anadskman/3D-Scanner/README.md

# Portable 3D Scanner


A custom-designed portable 3D scanner built from scratch in Fusion 360 and KiCad. The scanner uses a motorised arch and rotating turntable to capture objects from different angles and create 3D models.

The design uses an ESP32, two NEMA 17 stepper motors, DRV8825 drivers and a 1080p USB camera.

## Overview

The scanner uses two motorised axes:

- Rotating turntable to move the object
- Motorised arch to move the camera around the object

The camera captures images from different angles while the ESP32 controls the movement of both motors.

The USB camera connects directly to a computer, where the images can be processed into a 3D model.

The main goal is to create a compact scanner that can be transported easily and used to scan smaller objects.

## Features

- Fully custom CAD design
- Custom designed PCB
- Motorised rotating turntable
- Motorised camera arch
- Internal gear mechanism
- 1080p USB camera
- WS2812 LED lighting
- Automatic homing using limit switches
- ESP32 motor control
- 3D printed components
- Modular and detachable components
- Designed to be portable

## Design Process

### Initial Concept

The original idea was to make a portable 3D scanner using a rotating turntable and a camera mounted on a curved arch.

Instead of moving multiple cameras around the object, the design uses one camera that can move to different positions while the turntable rotates.

The main parts were designed in Fusion 360, with the electronics designed separately in KiCad.

### Arch Mechanism

The arch holds the camera and allows it to move around the object.

The design uses an internal gear system to move the camera along the arch using a NEMA 17 stepper motor.

The arch includes:

- Internal gear teeth
- NEMA 17 motor mounting
- Camera mounting bracket
- Detachable mounting points
- Space for cable routing

The gear teeth were generated using Helix Gear+ in Fusion 360 rather than modelling each tooth individually.

### Turntable

The turntable rotates the object during scanning.

It uses a separate NEMA 17 stepper motor controlled by a DRV8825 driver.

The turntable is designed to hold smaller objects while keeping them centred during rotation.

### Camera Mount

The camera mount was designed specifically around the InnoMaker USB camera.

It attaches to the moving arch and holds the camera in position while allowing it to point towards the centre of the turntable.

### PCB Housing

A custom housing was designed for the PCB.

The housing includes cutouts for the barrel jack, screw terminals and connectors. It also has mounting holes for attaching the top and bottom sections together.

The ESP32 is removable rather than permanently enclosed inside the case.

## Electronics

### Components

- ESP32 Development Board
- 2× DRV8825 Stepper Drivers
- 2× NEMA 17 Stepper Motors
- InnoMaker 1080p USB Camera
- WS2812 RGB LED Ring
- 3× Limit Switches
- 12V Power Supply
- 5V Buck Converter
- Custom PCB

### PCB

The PCB was designed in KiCad and exported as a STEP model so it could be imported into Fusion 360.

This allowed the electronics to be placed into the mechanical assembly to check clearances and mounting positions.

## CAD Improvements

Several improvements were made throughout the design:

- Custom internal gear mechanism
- Modular motor mounts
- Detachable arch assembly
- Custom camera mount
- PCB housing with removable ESP32
- Standardised screw sizes
- STEP exports for individual components
- Full assembly with joints for movement testing
- PCB uploaded into Fusion 360 for clearance checking

## Bill of Materials

| **Name** | **Purpose** | **Quantity Purchased** | **Quantity Used** | **Link** | **Total Cost (EUR)** | **Distributor** |
| --- | --- | --- | --- | --- | --- | --- |
| InnoMaker 1080p USB Camera | Captures images of the object | 1 | 1 | [Amazon](https://www.amazon.ie/gp/product/B0CNCSFQC1/ref=ox_sc_act_title_5?smid=A3LR51RN935ZZX&psc=1) | €20.92  | Amazon |
| NEMA 17 Stepper Motors | Drives the turntable and arch | 3 | 2 | [Amazon](https://www.amazon.ie/gp/product/B0FSPZT9P4/ref=ox_sc_act_title_4?smid=A3JL2PT0MX26A6&psc=1) | €27.00 | Amazon |
| WS2812 LED Rings | Provides lighting around the object | 5 | 1 | [Amazon](https://www.amazon.ie/gp/product/B0CMW5LWM2/ref=ox_sc_act_title_3?smid=A35XDNP896ERNI&psc=1) | €8.19 | Amazon |
| Limit Switches | Used for homing and movement limits | 3 | 3 | [Amazon](https://www.amazon.ie/Official-Switch-3-Piece-Compatible-Printers/dp/B09R3TWDSV/ref=sr_1_20?sr=8-20) | €4.99  | Amazon |
| ESP32 Development Board | Main controller for the scanner | 1 | 1 | [Amazon](https://www.amazon.ie/DollaTek-Development-Bluetooth-compatible-Ultra-Low-Consumption/dp/B0CXT3978J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) | 7.99  | Amazon |
| DRV8825 Stepper Drivers | Controls the NEMA 17 motors | 2 | 2 | Owned | Owned | Owned |
| Custom PCB | Connects the electronics together | 1 | 1 | [JlCPCB](https://cart.jlcpcb.com/quote/gerberviewThree/?qs=2035bd6f6bf045a4be76bd0e8a033c01_1_0_1_0_0.html) | €22.63 | JlCPCB |
| 12V DC Power Supply | Main power for the scanner | 1 | 1 | Owned | Owned | Owned |
| 5V Buck Converter | Converts 12V to 5V for the ESP32 and LEDs | 1 | 1 | [Amazon](https://www.amazon.ie/Converter-Adjustable-Voltage-Efficient-Regulator/dp/B0FLYNNNWL/ref=sr_1_1?sr=8-1) | €8.99 | Amazon |
| 74AHCT125 | Logic level shifting for the LED data signal | 1 | 1 | [Amazon](https://www.amazon.ie/Be-Your-Mind-SN74AHCT125N-Three-State/dp/B0DXK7PWTN/ref=sr_1_1?sr=8-1) | €9.49 | Amazon |
| 330Ω Resistor | LED data line protection | 1 | 1 | Owned | Owned | Owned |
| 1000µF Capacitor | Smooths the LED power supply | 1 | 1 | Owned | Owned | Owned |
| 100µF Capacitors | Filters power near the stepper drivers | 2 | 2 | Owned | Owned | Owned |
| 100nF Capacitors | Decoupling for the electronics | 2+ | 2+ | Owned | Owned | Owned |
| Barrel Jack | Main power input | 1 | 1 | Owned | Owned | Owned |
| Screw Terminals / Connectors | Connects motors and power wiring | As required | As required | Owned | Owned | Owned |
| Fuse | Protects the main power input | 1 | 1 | [Amazon](https://www.amazon.ie/SeKi-Micro-Fuse-Glass-Fuses/dp/B09JZHQYR6/ref=sr_1_2?sr=8-2) | €6.88 | Amazon |
| Fuse Holder | Holds the fuse | 1 | 1 | [Amazon](https://www.amazon.ie/ECSiNG-Holder-Transparent-Terminals-5x20mm/dp/B0C4983C7C/ref=sr_1_2?sr=8-2) | €7.49 | Amazon |
| SB540 Schottky diode | reverse polarary protection | 1 | 1 | [Amazon](https://www.amazon.ie/20-Pieces-SR540-Schottky-Rectifier/dp/B079KDRFY7/ref=sr_1_2?sr=8-2) | €6.26  | Amazon |
**Total** **€130.83**

Prices are for the full packs purchased, not the cost of only the parts used. The third stepper motor and spare LED rings are included in the purchase quantities.

## Project Images

### CAD



### PCB



### Schematic



---

**Designed and built by Jason Clark**
