anadskman/3D-Scanner/CAD/Arch Main.stl

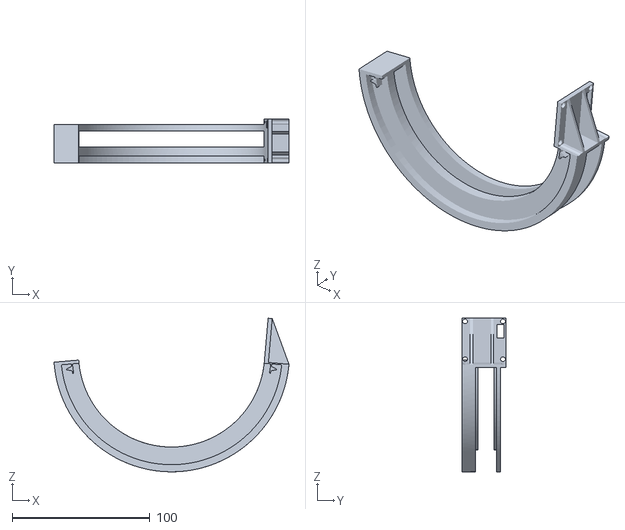
[picture p1: CAD file, 2026-11-04]
CAD/Arch Main.stl
170.5 x 32.0 x 111.5
