anadskman/3D-Scanner/CAD/Components/DRV8825_pin.stp

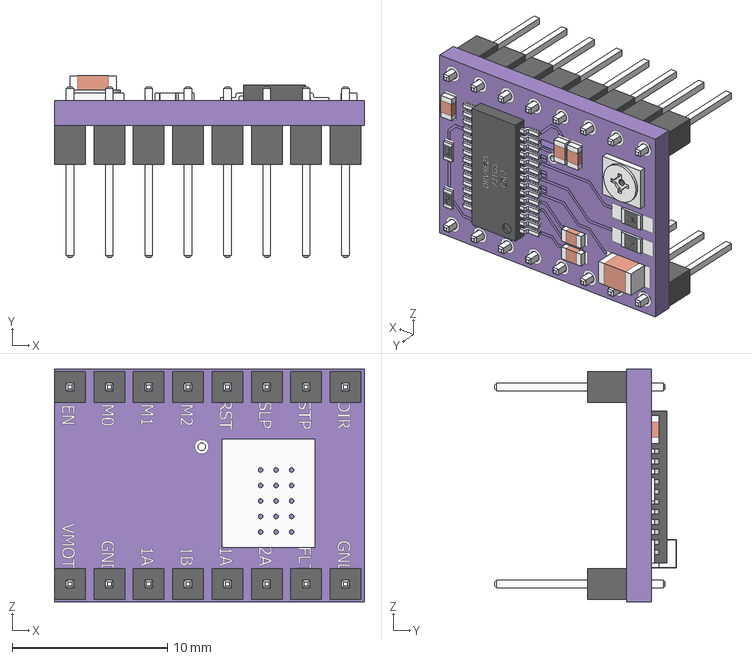
[picture p2: CAD file, 2026-10-27]
CAD/Components/DRV8825_pin.stp
20.0 x 11.7 x 15.0 mm
