anadskman/3D-Scanner/CAD/PCB Case Sides.stl

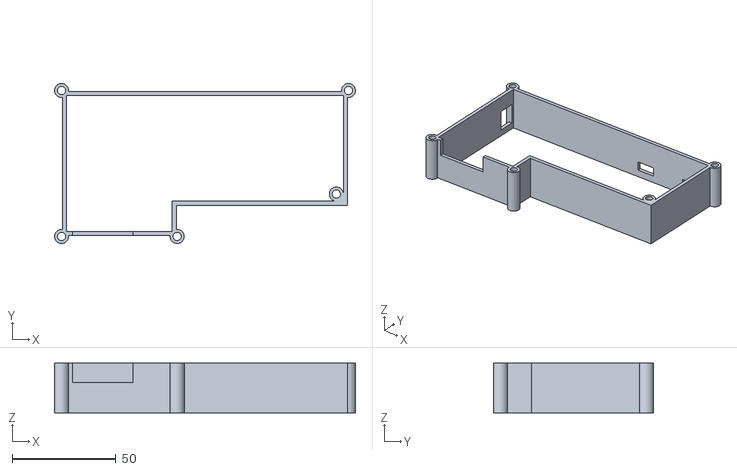
[picture p3: CAD file, 2026-11-04]
CAD/PCB Case Sides.stl
145.1 x 77.2 x 24.0
