anadskman/3D-Scanner/CAD/Components/3DScanner-PCB with models.step

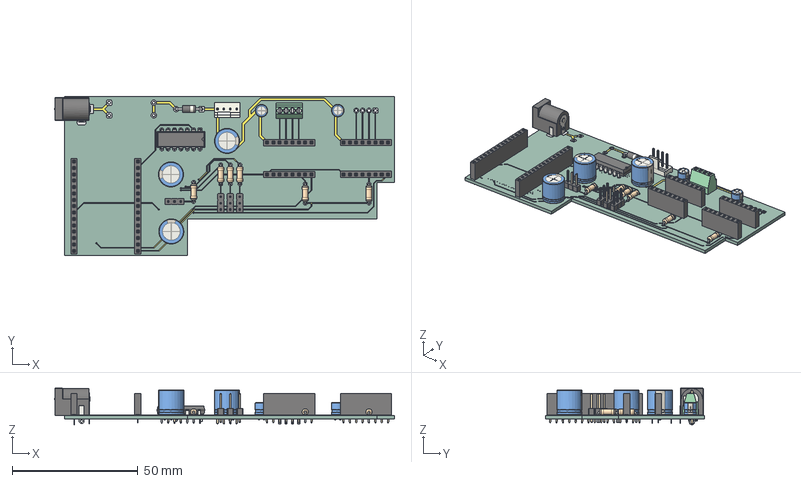
[picture p4: CAD file, 2026-10-27]
CAD/Components/3DScanner-PCB with models.step
135.4 x 63.5 x 14.6 mm
R_Axial_DIN0207_L6.3mm_D2.5mm_P7.62mm_Horizontal x 6
PinSocket_1x08_P2.54mm_Vertical x 4
PinSocket_1x15_P2.54mm_Vertical x 2
PinHeader_1x03_P2.54mm_Vertical x 4
FanPinHeader_1x04_P2.54mm_Vertical
TerminalBlock_Phoenix_MPT-0,5-4-2.54_1x04_P2.54mm_Horizontal
CP_Radial_D10.0mm_P5.00mm x 3
D_DO-41_SOD81_P10.16mm_Horizontal
CP_Radial_D5.0mm_P2.00mm x 2
DIP-14_W7.62mm
BarrelJack_Horizontal
3DScanner_copper
3DScanner_pad
3DScanner_via
3DScanner_PCB
