anadskman/3D-Scanner/CAD/Components/Innomaker-U20CAM-1080P-1 v1.step

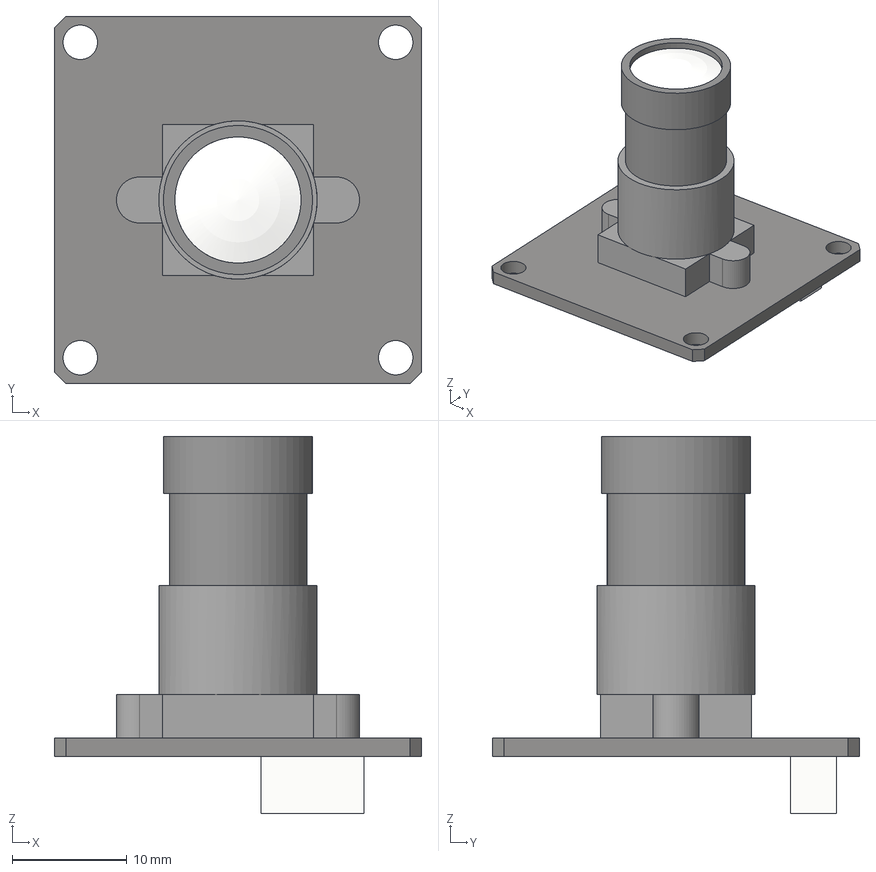
[picture p5: CAD file, 2026-10-21]
CAD/Components/Innomaker-U20CAM-1080P-1 v1.step
32.0 x 32.0 x 32.9 mm
PCB
Camera-Bot
Camera-Top
Connector
Lens
