anadskman/3D-Scanner/CAD/Guide Rails.stl

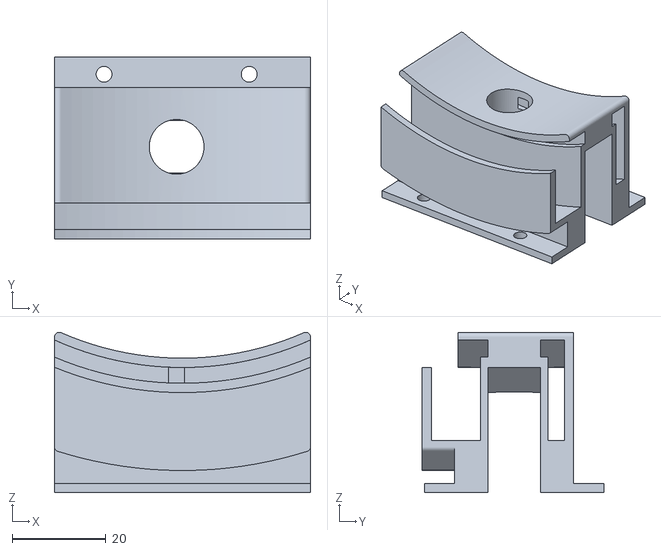
[picture p6: CAD file, 2026-11-04]
CAD/Guide Rails.stl
54.7 x 38.9 x 34.3
