anadskman/3D-Scanner/CAD/Arch 12 teeth gear.stl

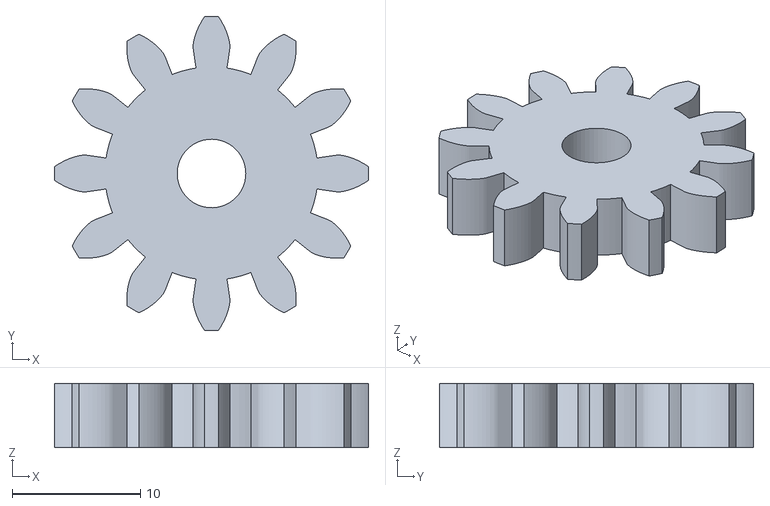
[picture p7: CAD file, 2026-11-04]
CAD/Arch 12 teeth gear.stl
24.5 x 24.5 x 5.00
