anadskman/3D-Scanner/CAD/Components/Creality Limit Switch.step

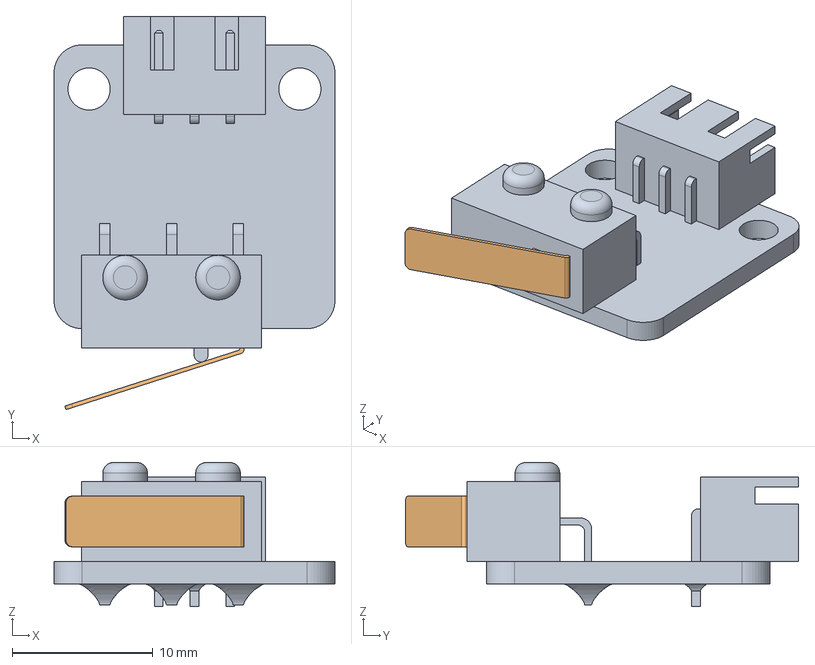
[picture p8: CAD file, 2026-10-21]
CAD/Components/Creality Limit Switch.step
20.0 x 28.0 x 10.3 mm
