anadskman/3D-Scanner/CAD/Arch Motor Mount.stl

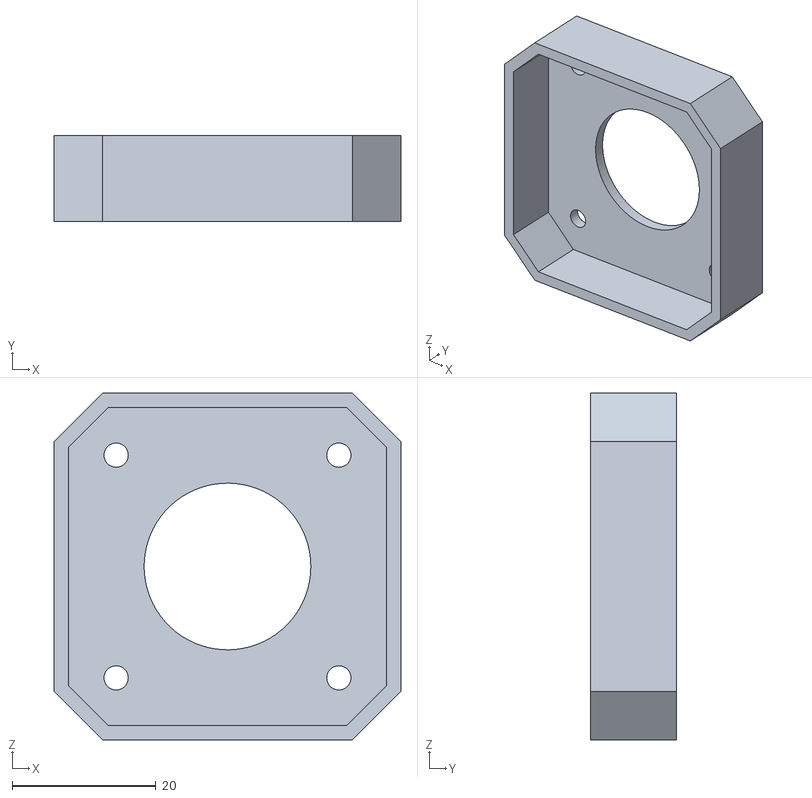
[picture p9: CAD file, 2026-11-04]
CAD/Arch Motor Mount.stl
48.3 x 12.0 x 48.3
