anadskman/3D-Scanner/CAD/Components/esp32_Wroom_30pins_C-Type.STEP

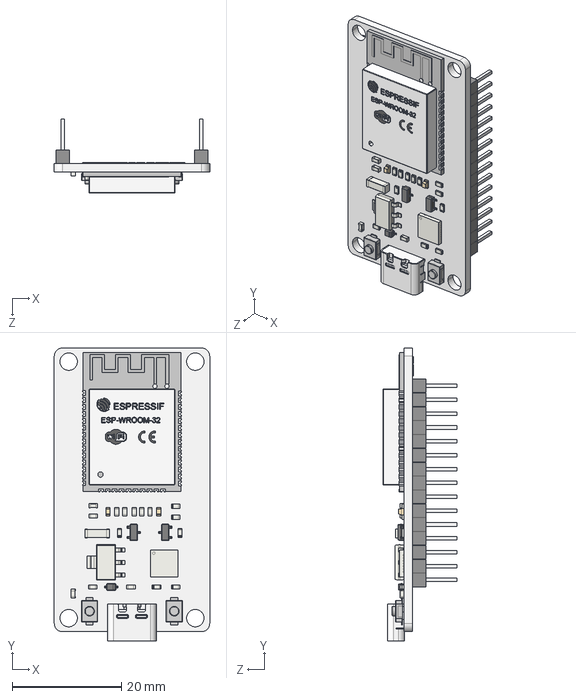
[picture p10: CAD file, 2026-10-21]
CAD/Components/esp32_Wroom_30pins_C-Type.STEP
28.5 x 53.7 x 13.7 mm
