anadskman/3D-Scanner/CAD/Components/DRV8825.stp

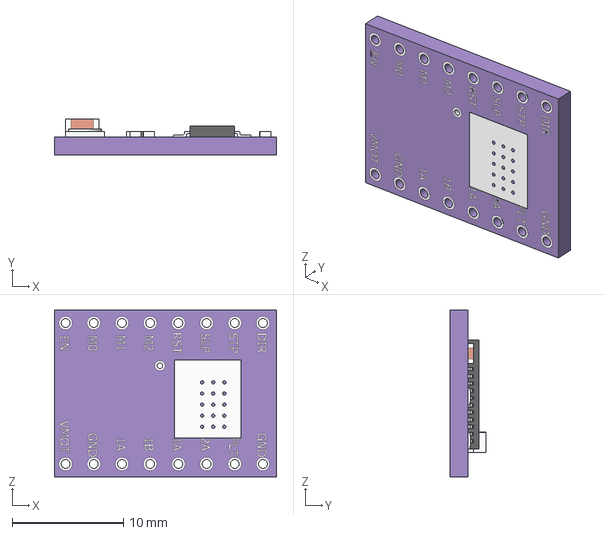
[picture p11: CAD file, 2026-10-21]
CAD/Components/DRV8825.stp
20.0 x 3.22 x 15.0 mm
