anadskman/3D-Scanner/CAD/PCB Case Bottom.stl

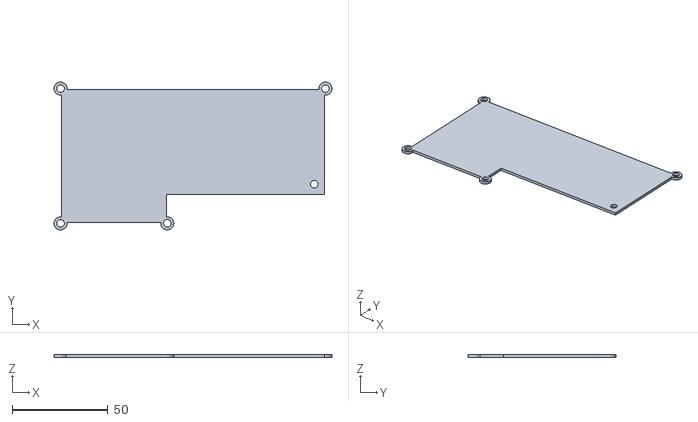
[picture p12: CAD file, 2026-11-04]
CAD/PCB Case Bottom.stl
145.1 x 77.2 x 1.50
