anadskman/3D-Scanner/CAD/Arch Teeth.stl

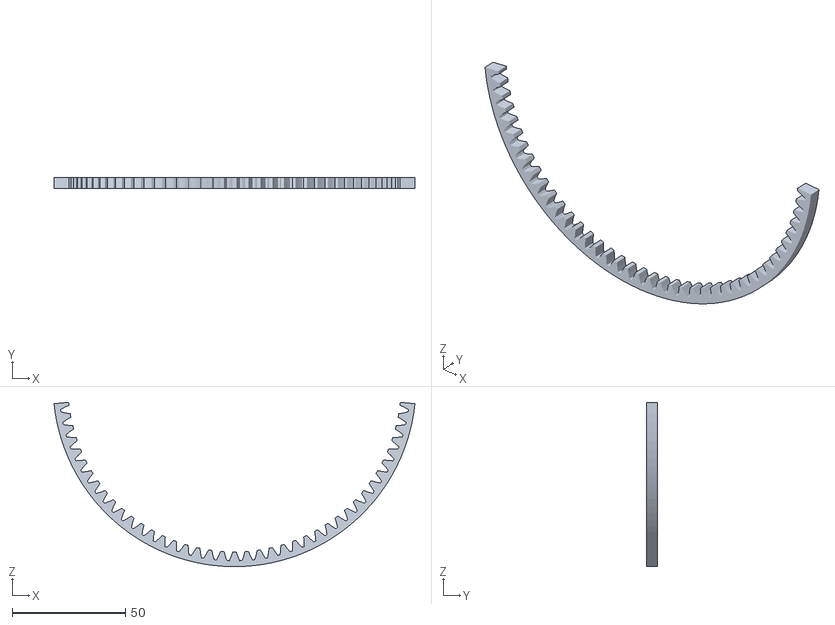
[picture p13: CAD file, 2026-11-04]
CAD/Arch Teeth.stl
159.2 x 5.00 x 72.4
