anadskman/3D-Scanner/CAD/Turntable.stl

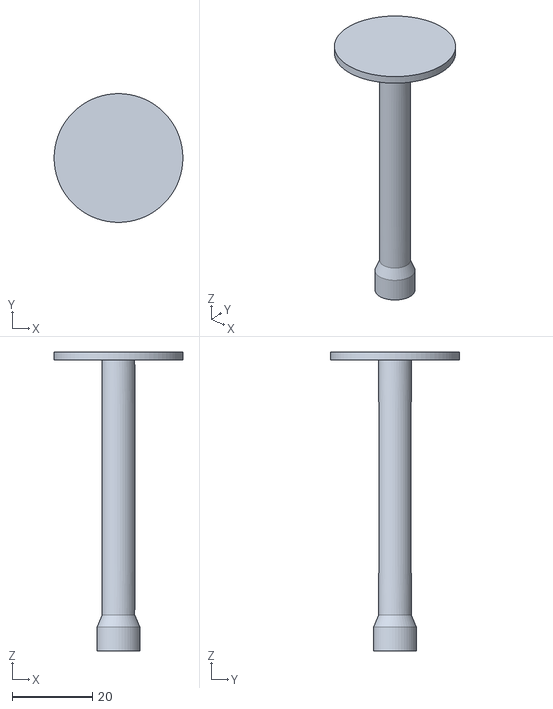
[picture p15: CAD file, 2026-11-04]
CAD/Turntable.stl
32.0 x 32.0 x 74.3
