anadskman/3D-Scanner/CAD/Turntable motor Mount.stl

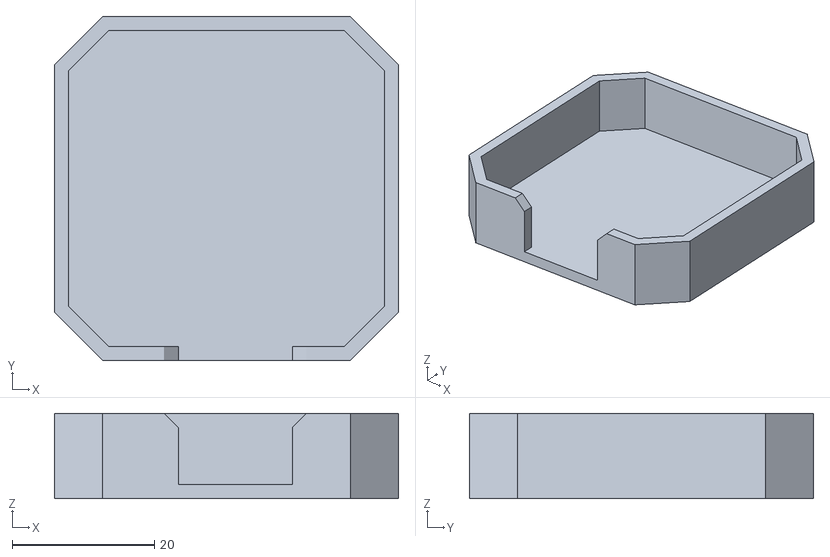
[picture p16: CAD file, 2026-11-04]
CAD/Turntable motor Mount.stl
48.3 x 48.3 x 12.0
