anadskman/3D-Scanner/CAD/3D Scanner.step

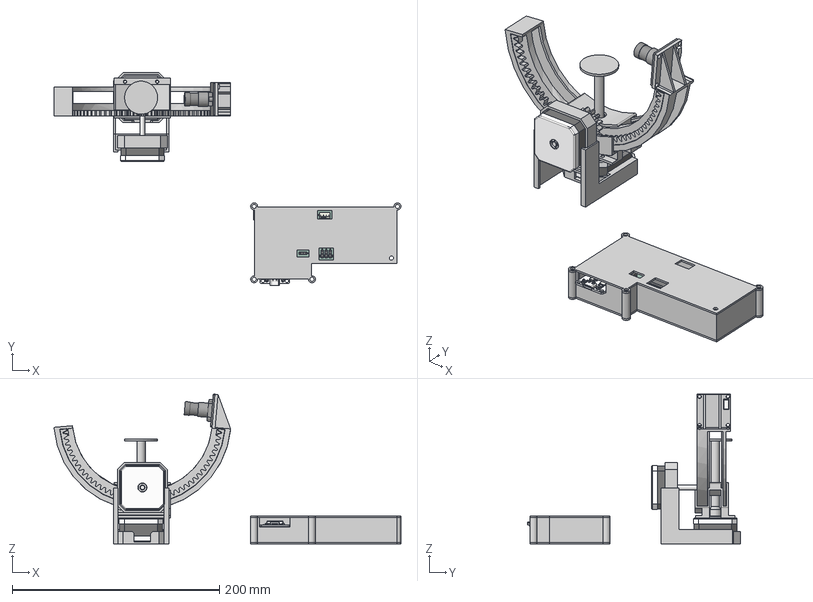
[picture p17: CAD file, 2026-11-04]
CAD/3D Scanner.step
334.9 x 205.2 x 144.6 mm
