anadskman/3D-Scanner/CAD/Motor Mount Connectors.stl

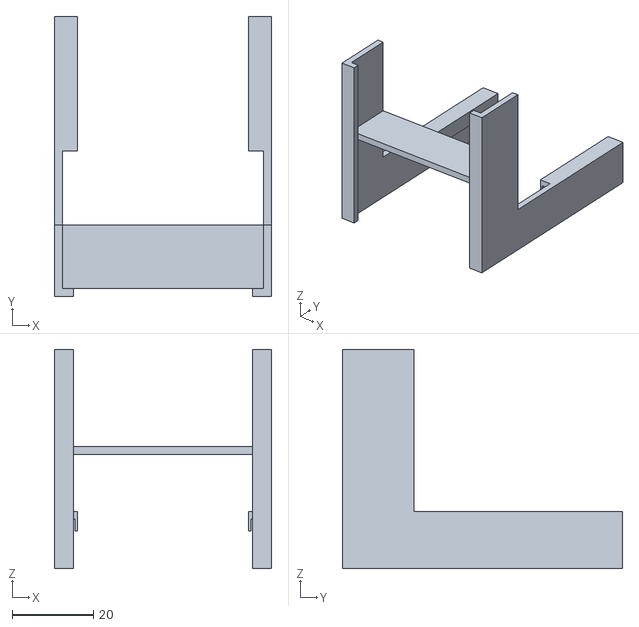
[picture p18: CAD file, 2026-11-04]
CAD/Motor Mount Connectors.stl
53.5 x 69.1 x 54.0
