anadskman/3D-Scanner/(list of files, cad)

Other CAD files:
CAD/3D Scanner.f3z
CAD/Components/NEMA17 stepper motor v39.f3d
