anadskman/3D-Scanner/PCB/3DScanner.kicad_pcb

## KiCad design PCB/3DScanner.kicad_pcb (2026-10-27)

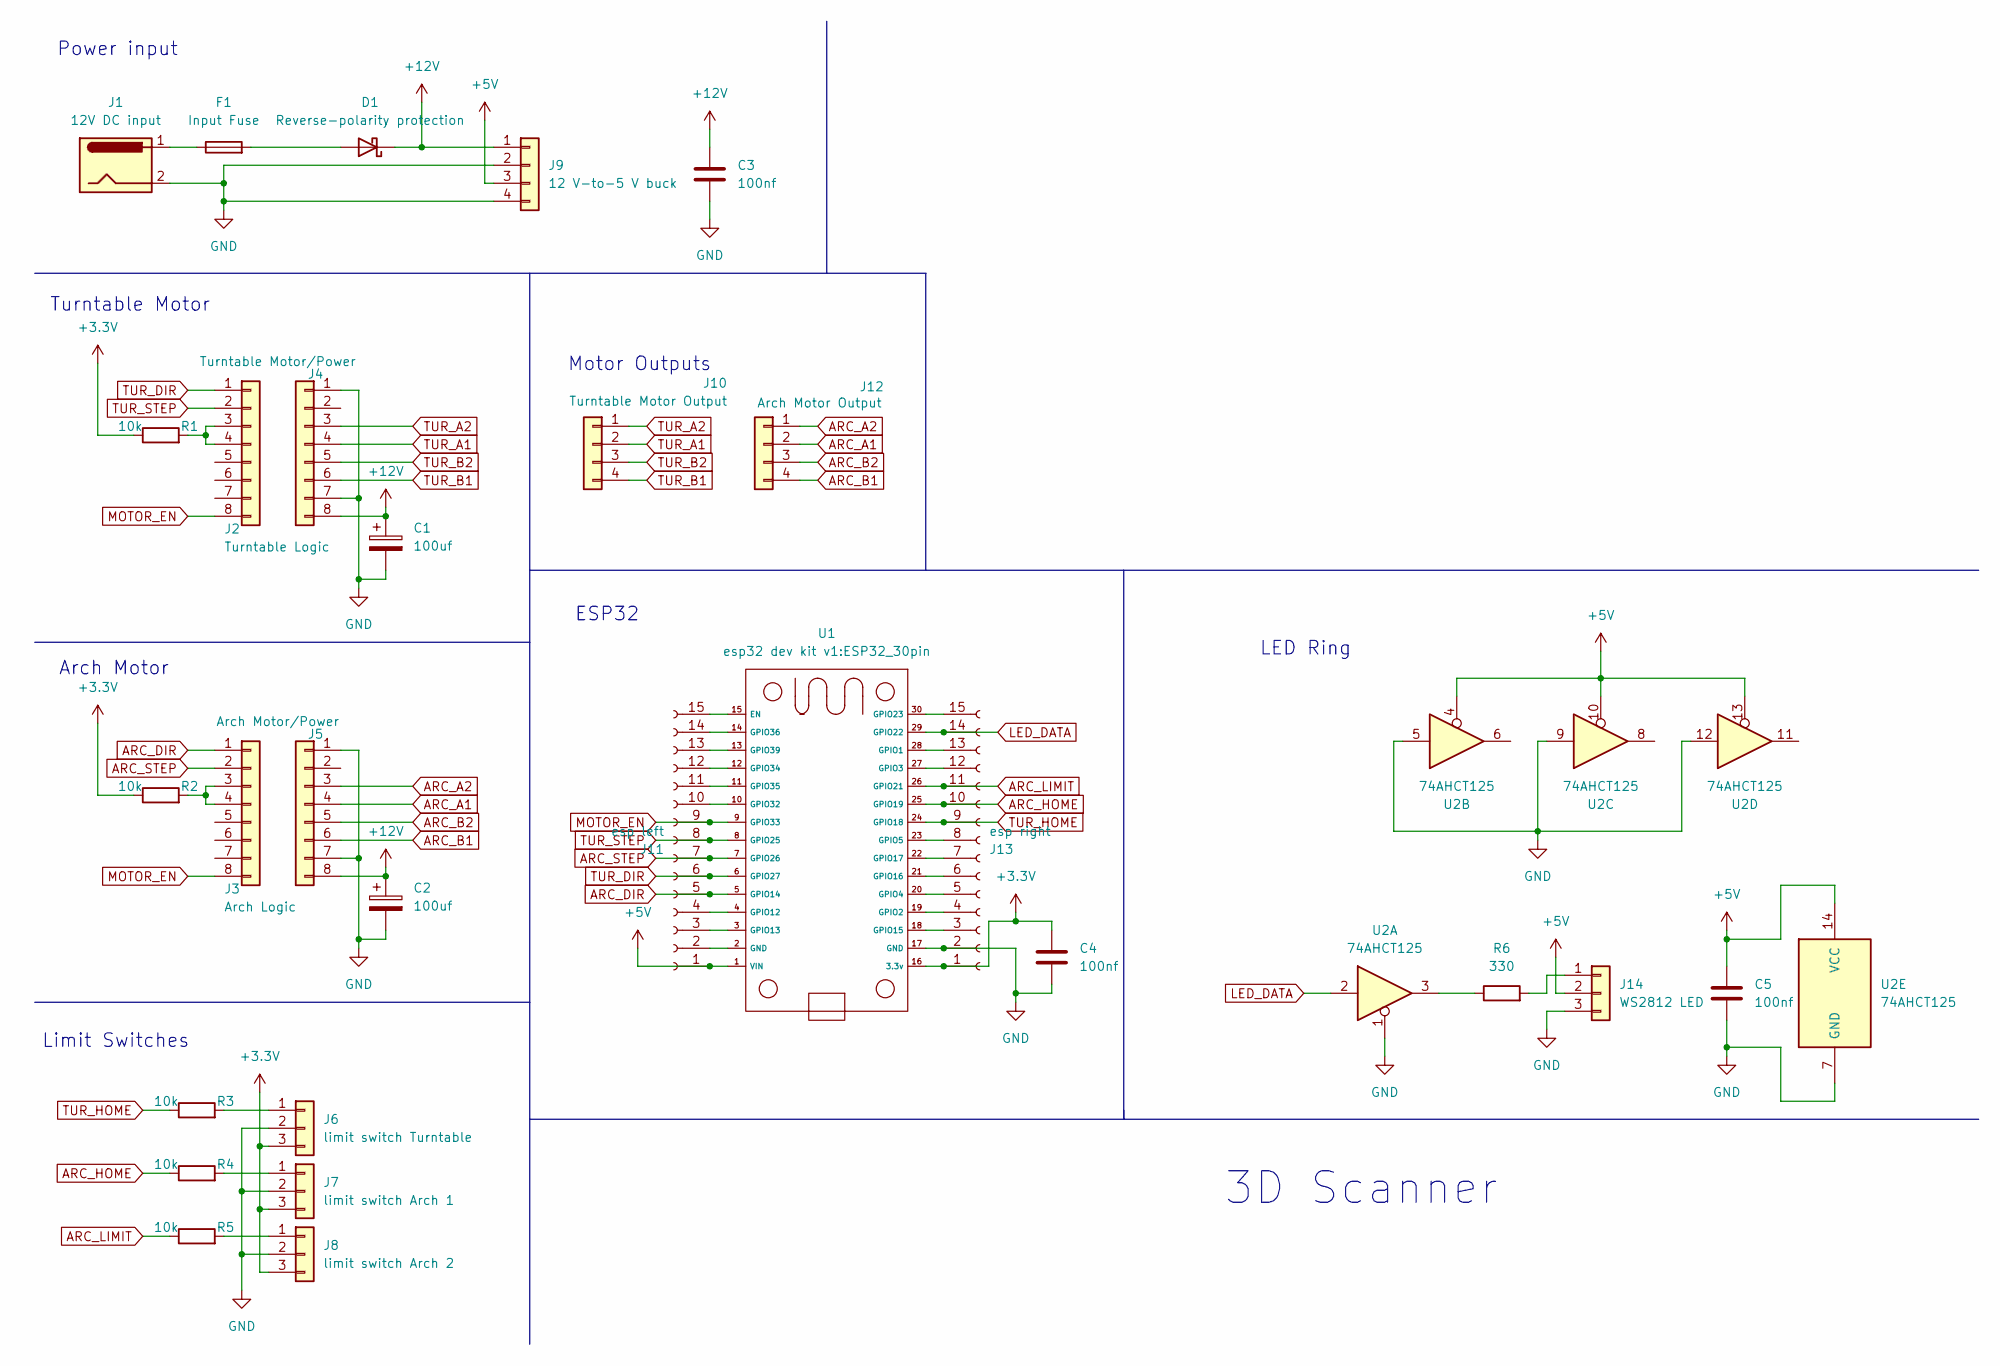
[picture p19: schematic 3DScanner.kicad_sch]

Parts:
C1, C2: 100uf; CP_Radial_D5.0mm_P2.00mm
C3, C4, C5: 100nf; CP_Radial_D10.0mm_P5.00mm
D1: Reverse-polarity protection; D_DO-41_SOD81_P10.16mm_Horizontal
F1: Input Fuse; Fuseholder_Clip-5x20mm_Bel_FC-203-22_Lateral_P17.80x5.00mm_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
J1: 12V DC input; BarrelJack_Horizontal
J2: Turntable Logic; PinSocket_1x08_P2.54mm_Vertical
J3: Arch Logic; PinSocket_1x08_P2.54mm_Vertical
J4: Turntable Motor/Power; PinSocket_1x08_P2.54mm_Vertical
J5: Arch Motor/Power; PinSocket_1x08_P2.54mm_Vertical
J6: limit switch Turntable; PinHeader_1x03_P2.54mm_Vertical
J7: limit switch Arch 1; PinHeader_1x03_P2.54mm_Vertical
J8: limit switch Arch 2; PinHeader_1x03_P2.54mm_Vertical
J9: 12 V-to-5 V buck; FanPinHeader_1x04_P2.54mm_Vertical
J10: Turntable Motor Output; TerminalBlock_Xinya_XY308-2.54-4P_1x04_P2.54mm_Horizontal
J11: esp left; PinSocket_1x15_P2.54mm_Vertical
J12: Arch Motor Output; TerminalBlock_Xinya_XY308-2.54-4P_1x04_P2.54mm_Horizontal
J13: esp right; PinSocket_1x15_P2.54mm_Vertical
J14: WS2812 LED; PinHeader_1x03_P2.54mm_Vertical
R1, R2, R3, R4, R5: 10k; R_Axial_DIN0207_L6.3mm_D2.5mm_P7.62mm_Horizontal
R6: 330; R_Axial_DIN0207_L6.3mm_D2.5mm_P7.62mm_Horizontal
U1: ESP32_30pin
U2: 74AHCT125; DIP-14_W7.62mm

Connections:
+3.3V: C4.1, J6.3 (VIN), J7.3 (VIN), J8.3 (VIN), J13.1, R1.1, R2.1, U1.16 (3.3v)
+5V: C5.1, J9.3, J11.1, J14.2 (+5V), U1.1 (VIN), U2.4, U2.10, U2.13, U2.14 (VCC)
+12V: C1.1, C2.1, C3.1, D1.1 (K), J4.8 (VMOT), J5.8 (VMOT), J9.1
ARC_A1: J5.4 (1A), J12.2
ARC_A2: J5.3 (2A), J12.1
ARC_B1: J5.6 (2B), J12.4
ARC_B2: J5.5 (1B), J12.3
ARC_DIR: J3.1 (Dir), J11.5, U1.5 (GPIO14)
ARC_HOME: J13.10, R4.1, U1.25 (GPIO19)
ARC_LIMIT: J13.11, R5.1, U1.26 (GPIO21)
ARC_STEP: J3.2 (STP), J11.7, U1.7 (GPIO26)
GND: C1.2, C2.2, C3.2, C4.2, C5.2, J1.2, J4.1 (GND), J4.7 (GND), J5.1 (GND), J5.7 (GND), J6.2 (GND), J7.2 (GND), J8.2 (GND), J9.2, J9.4, J13.2, J14.3 (GND), U1.17 (GND), U2.1, U2.5, U2.7 (GND), U2.9, U2.12
LED_DATA: J13.14, U1.29 (GPIO22), U2.2
MOTOR_EN: J2.8 (EN), J3.8 (EN), J11.9, U1.9 (GPIO33)
unnamed: D1.2 (A), F1.2
unnamed: F1.1, J1.1
unnamed: J2.3 (SLP), J2.4 (RST), R1.2
unnamed: J3.3 (SLP), J3.4 (RST), R2.2
unnamed: J6.1 (TUR_HOME), R3.2
unnamed: J7.1 (ARC_HOME), R4.2
unnamed: J8.1 (ARC_LIMIT), R5.2
unnamed: J11.2, U1.2 (GND)
unnamed: J11.3, U1.3 (GPIO13)
unnamed: J11.4, U1.4 (GPIO12)
unnamed: J11.10, U1.10 (GPIO32)
unnamed: J11.11, U1.11 (GPIO35)
unnamed: J11.12, U1.12 (GPIO34)
unnamed: J11.13, U1.13 (GPIO39)
unnamed: J11.14, U1.14 (GPIO36)
unnamed: J11.15, U1.15 (EN)
unnamed: J13.3, U1.18 (GPIO15)
unnamed: J13.4, U1.19 (GPIO2)
unnamed: J13.5, U1.20 (GPIO4)
unnamed: J13.6, U1.21 (GPIO16)
unnamed: J13.7, U1.22 (GPIO17)
unnamed: J13.8, U1.23 (GPIO5)
unnamed: J13.12, U1.27 (GPIO3)
unnamed: J13.13, U1.28 (GPIO1)
unnamed: J13.15, U1.30 (GPIO23)
unnamed: J14.1 (LED_DI), R6.2
unnamed: R6.1, U2.3
TUR_A1: J4.4 (1A), J10.2
TUR_A2: J4.3 (2A), J10.1
TUR_B1: J4.6 (2B), J10.4
TUR_B2: J4.5 (1B), J10.3
TUR_DIR: J2.1 (Dir), J11.6, U1.6 (GPIO27)
TUR_HOME: J13.9, R3.1, U1.24 (GPIO18)
TUR_STEP: J2.2 (STP), J11.8, U1.8 (GPIO25)

Notes on the sheet:
Turntable Motor
Motor Outputs
3D Scanner
Limit Switches
Arch Motor
Power input
ESP32
LED Ring

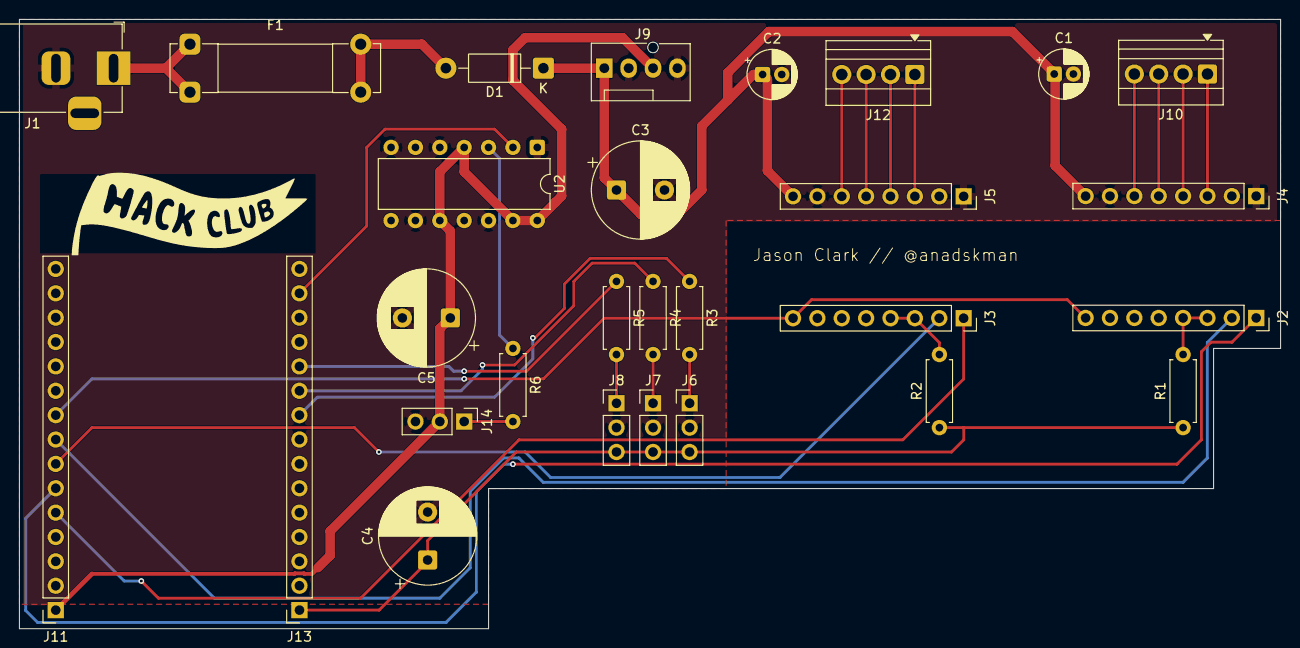
[picture p20: board 3DScanner.kicad_pcb from above]

Board: 2 copper layers, 131.4 x 63.5 mm, 28 parts (0 on the bottom side), 30 nets.
