anadskman/3D-Scanner/(commit log)

2026-10-21 uploaded components
    [Creality Limit Switch.step, DRV8825.stp, Innomaker-U20CAM-1080P-1 v1.step, NEMA17 stepper motor v39.f3d, esp32_Wroom_30pins_C-Type.STEP]
2026-10-27 Current Progress
    [3D Scanner.step, 3DScanner-PCB with models.step, 3DScanner.kicad_pcb, 3DScanner.kicad_sch, DRV8825_pin.stp]
2026-11-04 upload of all files
    [3D Scanner.f3z, 3D Scanner.step, Arch 12 teeth gear.stl, Arch Main.stl, Arch Motor Mount.stl, Arch Teeth.stl, Guide Rails.stl, Motor Mount Connectors.stl]
2026-11-04 Revise PCB details and add Bill of Materials
    Updated PCB description and added a detailed Bill of Materials with links and costs for components used in the project.
2026-11-04 Fix price for Limit Switches in README
    Updated the price of Limit Switches in the components table.
2026-11-04 Fix cost of Limit Switches in BOM.csv
    Updated the cost of Limit Switches from 20.92 EUR to 4.99 EUR.
    [BOM.csv]
